claudejpb-create/inner-swing-desktop/photos/PXL_20261020_204703219.jpg

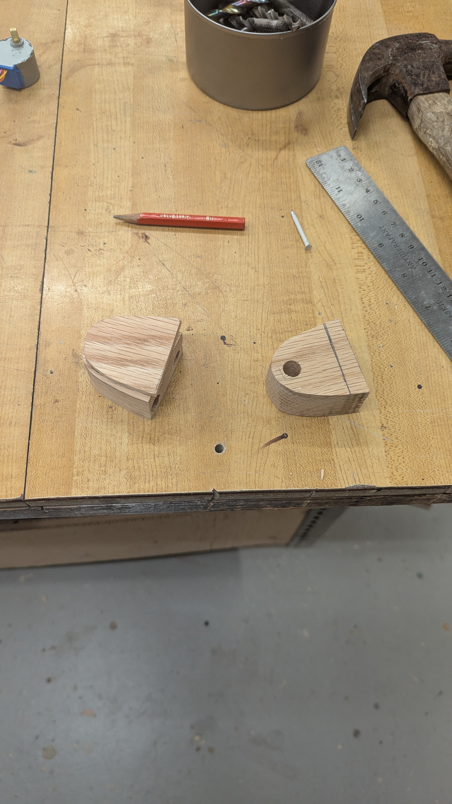
photos/PXL_20261020_204703219.jpg
