claudejpb-create/inner-swing-desktop/photos/PXL_20261020_204707203.jpg

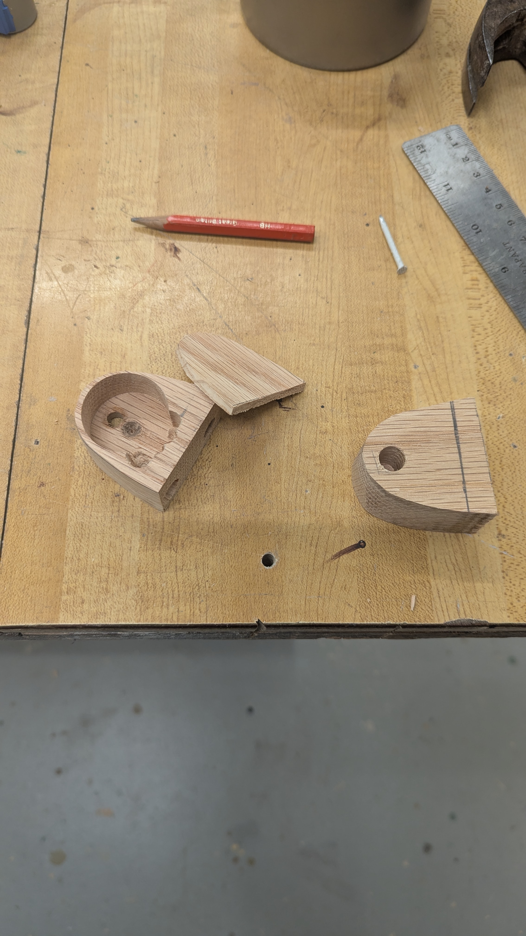
photos/PXL_20261020_204707203.jpg
