claudejpb-create/inner-swing-desktop/photos/PXL_20261020_175126625.jpg

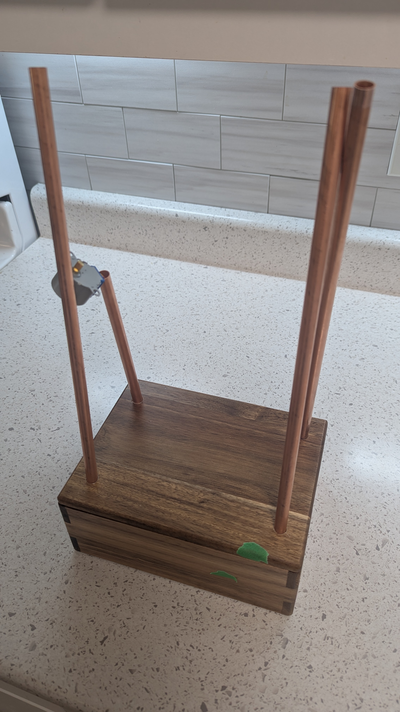
photos/PXL_20261020_175126625.jpg
