claudejpb-create/inner-swing-desktop/photos/PXL_20261020_211438156.jpg

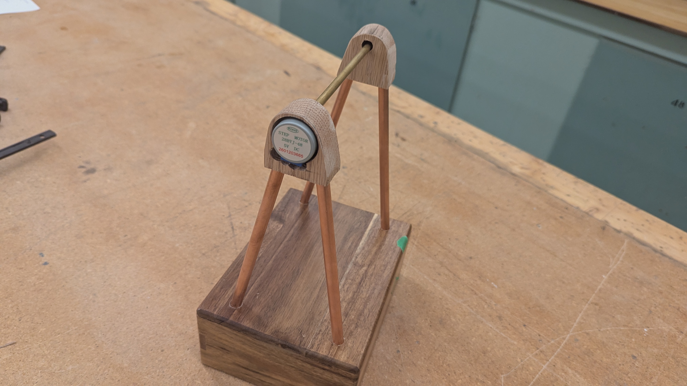
photos/PXL_20261020_211438156.jpg
